RyotaYoneyama/wormy_arm/wormy_arm_description/urdf/raw/link_2_collision.stl

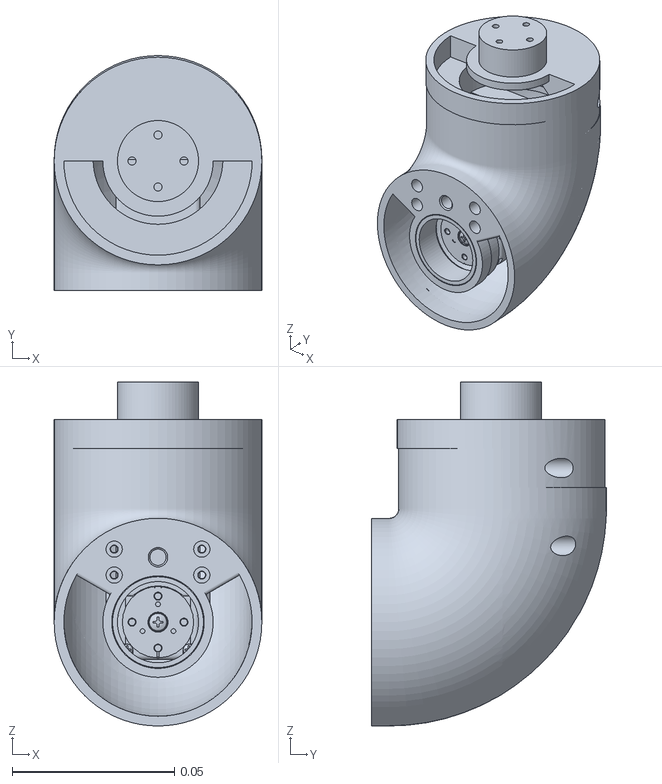
[picture p4: CAD file, 2023-02-13]
wormy_arm_description/urdf/raw/link_2_collision.stl
0.064 x 0.0724 x 0.106
