RyotaYoneyama/wormy_arm/wormy_arm_description/urdf/raw/joint_connector_a2_visual.stl

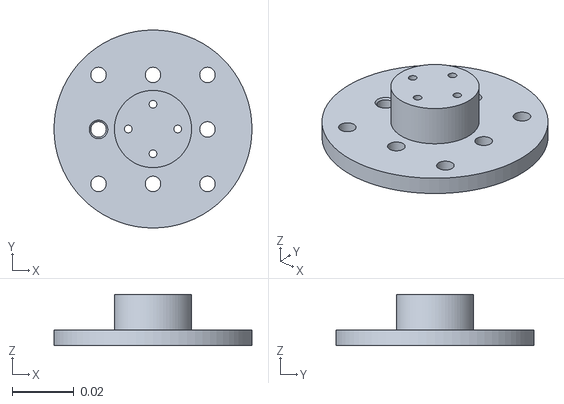
[picture p5: CAD file, 2023-02-13]
wormy_arm_description/urdf/raw/joint_connector_a2_visual.stl
0.064 x 0.064 x 0.0165
