RyotaYoneyama/wormy_arm/(list of files, cad)

Other CAD files:
wormy_arm_description/urdf/raw/link_1_collision.stl
wormy_arm_description/urdf/raw/link_5_visual.stl
wormy_arm_description/urdf/raw/link_2_visual.stl
wormy_arm_description/urdf/raw/link_4_collision.stl
wormy_arm_description/urdf/raw/joint_connector_a2_collision.stl
wormy_arm_description/urdf/raw/link_3_visual.stl
wormy_arm_description/urdf/raw/link_1_visual.stl
wormy_arm_description/urdf/raw/link_4_visual.stl
wormy_arm_description/urdf/raw/link_5_collision.stl
wormy_arm_description/urdf/raw/link_3_collision.stl
