RyotaYoneyama/wormy_arm/wormy_arm_moveit/wormy_short_moveit/config/joint_limits.yaml

# joint_limits.yaml allows the dynamics properties specified in the URDF to be overwritten or augmented as needed
# Specific joint properties can be changed with the keys [max_position, min_position, max_velocity, max_acceleration]
# Joint limits can be turned off with [has_velocity_limits, has_acceleration_limits]
joint_limits:
  joint_0:
    has_velocity_limits: true
    max_velocity: 6.28
    has_acceleration_limits: true
    max_acceleration: 30
  joint_1:
    has_velocity_limits: true
    max_velocity: 6.28
    has_acceleration_limits: true
    max_acceleration: 30
  joint_2:
    has_velocity_limits: true
    max_velocity: 6.28
    has_acceleration_limits: true
    max_acceleration: 30
  joint_3:
    has_velocity_limits: true
    max_velocity: 6.28
    has_acceleration_limits: true
    max_acceleration: 30
  joint_4:
    has_velocity_limits: true
    max_velocity: 6.28
    has_acceleration_limits: true
    max_acceleration: 30
  joint_5:
    has_velocity_limits: true
    max_velocity: 6.28
    has_acceleration_limits: true
    max_acceleration: 30
