RyotaYoneyama/wormy_arm/wormy_arm_control/include/wormy_arm_control/visibility_control.h

// Copyright 2017 Open Source Robotics Foundation, Inc.
//
// Licensed under the Apache License, Version 2.0 (the "License");
// you may not use this file except in compliance with the License.
// You may obtain a copy of the License at
//
//     http://www.apache.org/licenses/LICENSE-2.0
//
// Unless required by applicable law or agreed to in writing, software
// distributed under the License is distributed on an "AS IS" BASIS,
// WITHOUT WARRANTIES OR CONDITIONS OF ANY KIND, either express or implied.
// See the License for the specific language governing permissions and
// limitations under the License.

/* This header must be included by all rclcpp headers which declare symbols
 * which are defined in the rclcpp library. When not building the rclcpp
 * library, i.e. when using the headers in other package's code, the contents
 * of this header change the visibility of certain symbols which the rclcpp
 * library cannot have, but the consuming code must have inorder to link.
 */

#ifndef __VISIBILITY_CONTROL_H__
#define __VISIBILITY_CONTROL_H__

// This logic was borrowed (then namespaced) from the examples on the gcc wiki:
//     https://gcc.gnu.org/wiki/Visibility

#if defined _WIN32 || defined __CYGWIN__
#ifdef __GNUC__
#define CRANE_PLUS_CONTROL_EXPORT __attribute__((dllexport))
#define CRANE_PLUS_CONTROL_IMPORT __attribute__((dllimport))
#else
#define CRANE_PLUS_CONTROL_EXPORT __declspec(dllexport)
#define CRANE_PLUS_CONTROL_IMPORT __declspec(dllimport)
#endif
#ifdef CRANE_PLUS_CONTROL_BUILDING_DLL
#define CRANE_PLUS_CONTROL_PUBLIC CRANE_PLUS_CONTROL_EXPORT
#else
#define CRANE_PLUS_CONTROL_PUBLIC CRANE_PLUS_CONTROL_IMPORT
#endif
#define CRANE_PLUS_CONTROL_PUBLIC_TYPE CRANE_PLUS_CONTROL_PUBLIC
#define CRANE_PLUS_CONTROL_LOCAL
#else
#define CRANE_PLUS_CONTROL_EXPORT __attribute__((visibility("default")))
#define CRANE_PLUS_CONTROL_IMPORT
#if __GNUC__ >= 4
#define CRANE_PLUS_CONTROL_PUBLIC __attribute__((visibility("default")))
#define CRANE_PLUS_CONTROL_LOCAL __attribute__((visibility("hidden")))
#else
#define CRANE_PLUS_CONTROL_PUBLIC
#define CRANE_PLUS_CONTROL_LOCAL
#endif
#define CRANE_PLUS_CONTROL_PUBLIC_TYPE
#endif

#endif  // __VISIBILITY_CONTROL_H__
