RyotaYoneyama/wormy_arm/(commit log)

2023-01-29 First comit
    [ax-12a.stl, base_case.stl, base_cover.stl, base_mount_motor.stl, base_mount_raspberrypi.stl, bush.stl, cap_bolt_m2(l=8).stl, cap_bolt_m3(l=10).stl]
2023-02-13 座標軸が逆になっていたため修正
    [joint_connector_a2_collision.stl, joint_connector_a2_visual.stl, link_1_collision.stl, link_1_visual.stl, link_2_collision.stl, link_2_visual.stl, link_3_collision.stl, link_3_visual.stl]
